elhep/SpaceVPX_FMC_Carrier_3U/IMG/render3U.png

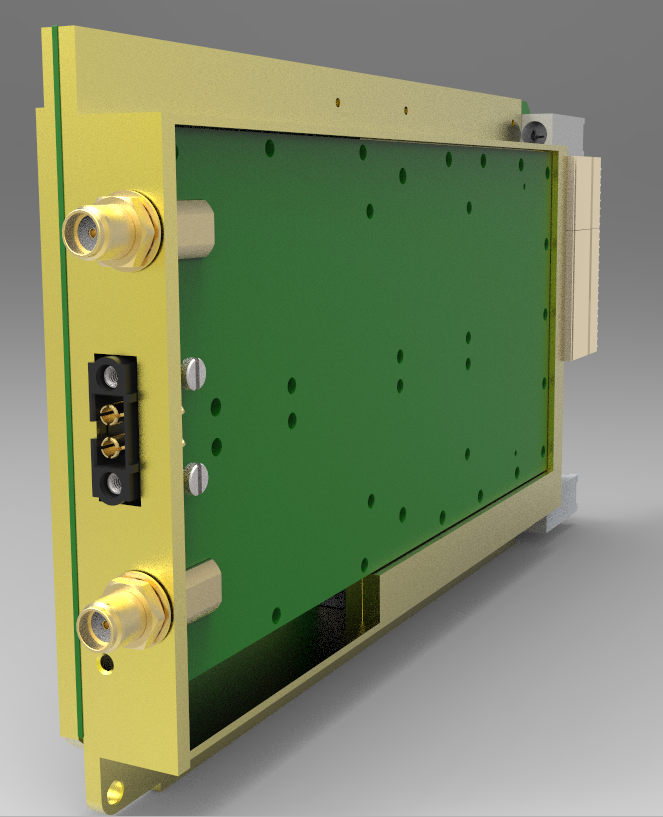
IMG/render3U.png
