elhep/SpaceVPX_FMC_Carrier_3U/IMG/3U_top_with_FMC_SDR.png

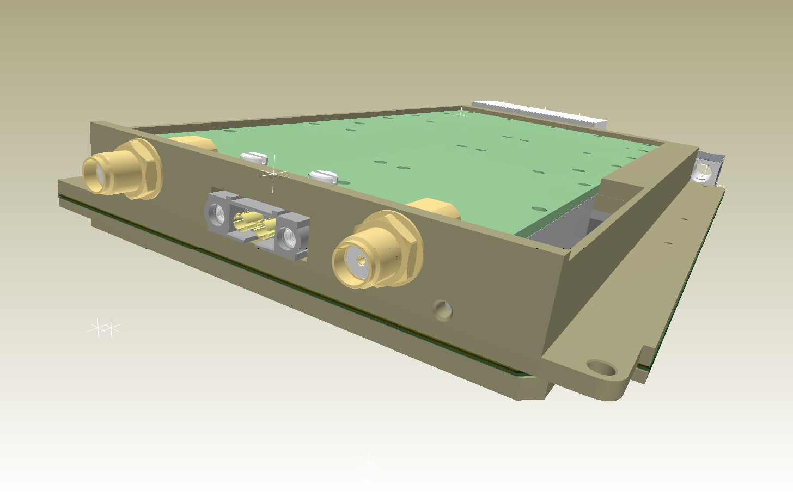
IMG/3U_top_with_FMC_SDR.png
