elhep/SpaceVPX_FMC_Carrier_3U/IMG/3U_top.png

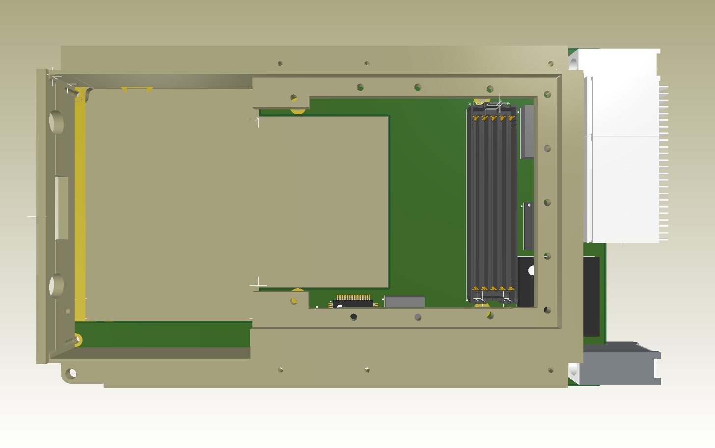
IMG/3U_top.png
