elhep/SpaceVPX_FMC_Carrier_3U/CALC/PSU_Calc.xlsx

LT8610
R2 | Vout | Vin | n | Fsw[MHz] | I load max | RT[k] | Fsw max | R1 | Iq | Lopt[uH] | dIl | IL peak | I out max
1000 | 3.3 | 12 | 0.8 | 1 | 2.5 | 41.3 | 5822784.81 | 2402.061856 | 0.0003351375 | 3.45 | 0.6934782609 | 2.84673913 | 2.65326087
R2 | Vout | Vin | n | Fsw[MHz] | I load max | RT[k] | Fsw max | R1 | Iq | Lopt[uH] | dIl | IL peak | I out max
1000 | 2.5 | 12 | 0.8 | 1 | 2.5 | 41.3 | 4472573.84 | 1577.319588 | 0.0002543041667 | 2.65 | 0.7468553459 | 2.873427673 | 2.626572327
R2 | Vout | Vin | n | Fsw[MHz] | I load max | RT[k] | Fsw max | R1 | Iq | Lopt[uH] | dIl | IL peak | I out max
1000 | 1.5 | 12 | 0.8 | 1 | 2.5 | 41.3 | 2784810.127 | 546.3917526 | 0.0001532625 | 1.65 | 0.7954545455 | 2.897727273 | 2.602272727
LT8612
R2 | Vout | Vin | n | Fsw[MHz] | I load max | RT[k] | Fsw max | R1 | Iq | Lopt[uH] | dIl | IL peak | I out max
1000 | 1 | 12 | 0.8 | 1 | 6 | 41.3 | 1952461.8 | 30.92783505 | 0.0001027416667 | 0.826 | 1.10976594 | 6.55488297 | 8.44511703
