elhep/SpaceVPX_FMC_Carrier_3U/(list of files, drawings)

Other design files:
SVPX.SchLib
SVPX_FMC_3U_PCB/SCH/CLK_Protection.SchDoc
SVPX_FMC_3U_PCB/SCH/Decoupling_caps.SchDoc
SVPX_FMC_3U_PCB/SCH/FMC_connector.SchDoc
SVPX_FMC_3U_PCB/SCH/FPGA SDRAM bank.SchDoc
SVPX_FMC_3U_PCB/SCH/FPGA Supply.SchDoc
SVPX_FMC_3U_PCB/SCH/FPGA_Config.SchDoc
SVPX_FMC_3U_PCB/SCH/FPGA_FMC.SchDoc
SVPX_FMC_3U_PCB/SCH/FPGA_MGT.SchDoc
SVPX_FMC_3U_PCB/SCH/FPGA_Misc.SchDoc
SVPX_FMC_3U_PCB/SCH/FPGA_SpW_Misc.SchDoc
SVPX_FMC_3U_PCB/SCH/Interface_Protection.SchDoc
SVPX_FMC_3U_PCB/SCH/Management.SchDoc
SVPX_FMC_3U_PCB/SCH/MSP430_power_jtag.SchDoc
SVPX_FMC_3U_PCB/SCH/Power_supply.SchDoc
SVPX_FMC_3U_PCB/SCH/SLT3-PAY-1Q2T_P0.SchDoc
SVPX_FMC_3U_PCB/SCH/SLT3-PAY-1Q2T_P1.SchDoc
SVPX_FMC_3U_PCB/SCH/SLT3-PAY-1Q2T_P2.SchDoc
SVPX_FMC_3U_PCB/SCH/SVPX_protection.SchDoc
SVPX_FMC_3U_PCB/SCH/SVPXFMC_Carrier_3U.SchDoc
SVPX_FMC_3U_PCB/SCH/WR_OSC.SchDoc
SVPX_FMC_3U_PCB/SVPXFMC_Carrier_3U.PrjPcb
