elhep/SpaceVPX_FMC_Carrier_3U/(threads)

Thread 1 (2018-10-31):

schematic review

gkasprow, 2018-10-31:

mkuklewski, 2019-02-06:
One of small issue is lack of harnesses files.
Please add them to repository.

gkasprow, 2019-02-06:
Harness files are generated during compilation.

Thread 2 (2019-02-05):

SpaceVPX connector pinout change.

mkuklewski, 2019-02-05:
During further development of the project and review,  the need to change the pinout became apparent.
First all connectors should be grouped to different sheets and named after each connector (and those placed into one, from which all harness should spread) and all pins should be named after standard.

Naming of each sheet should be like this:
SLT3-PAY-1Q2T-HS_COMM
SLT3-PAY-1Q2T-HS_COMM_P0
SLT3-PAY-1Q2T-HS_COMM_P1
etc.

Pinout of the SpaceVPX connector is here:
https://docs.google.com/spreadsheets/d/13T0c5s93cGWtUubSEh7cbfTNiu5ucbjdAXt16fslpvk/edit?usp=sharing

tprzywoz, 2019-03-05:
Done. In MSP430_power_jtag sheet I added TVS diode to MCU_UART.

Closed 2019-06-17.

Thread 4 (2019-02-05):

Fault isolation betwean 12V and 3V3 domains.

biedam, 2019-02-05:
FPGA power supply is not fault isolated from P3V3MP supply. In the case of management failure and 3V3MP cutt-off, whole module is not operable. PG, ENA and MAX4372 power supply should be connected to 12V.

tprzywoz, 2019-03-05:
done

Closed 2019-06-17.

Thread 5 (2019-02-07):

LPDDR

mkuklewski, 2019-02-07:
There are two issues here:
1.  Resistor connected to D7 MDDR_IMP_CALIB (FPGA_Config_SchDoc) should be 150 Ohm (according to Pin_Descripions_Datasheet),
2. Two pins on MT46H64M32LFBQ-48 should be swapped - F2 with E2.

tprzywoz, 2019-03-05:
done

tprzywoz, 2019-04-02:
I'm confused. According to [DS0115](https://www.microsemi.com/document-portal/doc_view/130718-ds0115-smartfusion2-pin-descriptions-datasheet) D7 MDDR_IMP_CALIB resistor should be 150 Ohm and clk lines don't have termination resistor. According to [AC393](https://www.microsemi.com/document-portal/doc_view/129979-ac393-board-and-layout-design-guidelines-for-smartfusion2-soc-and-igloo2-fpgas-application-note) it should be 240 Ohm and there is a 100 Ohm termination at the end of clk lines. M2S090TS-EVAL-KIT is designed according to AC393, although it has same memory chip as DS0115 example.

mkuklewski, 2019-04-02:
In my opinion there is something not mentioned inside AC393 and its configuration (for example IO calibration is off) or there is an error in documentation. I would use 150 Ohms resistor (same voltage as DDR2 interface, which is also not done correctly in this document).
As for 100 Ohm resistor, it should be included, because MT46H64M32LFBQ CLK inputs are differential.

tprzywoz, 2019-04-14:
I used 150 Ohm resistor + added 100 Ohm resistor at LPDDR's CLK inputs

Closed 2019-04-14.

Thread 6 (2019-02-11):

FPGA Supply - Capacitors and resistors

mkuklewski, 2019-02-11:
According to Microsemi_SmartFusion2_IGLOO2_Board_and_Layout_Design_Guidelines_Application_Note_AC393_V13.pdf there is not enough decoupling capacitors.
For XXXX should be:
- VDDI1 - 7 x 0.01 μF,  7 x 0.1 μF, 2 x 47 μF
- VDDI2 - 2 x 0.01 μF,  2 x 0.1 μF, 1 x 10 μF
- VDDI3 - 2 x 0.01 μF,  2 x 0.1 μF, 1 x 10 μF
- VDDI4 - 1 x 0.01 μF, 1 x 10 μF
- VDDI5 - please add to those which already are 2 x 0.01 μF,  2 x 0.1 μF
- VDDI6 - please add to those which already are 2 x 0.01 μF,  2 x 0.1 μF
- VDDI7 - please add to those which already are 2 x 0.01 μF,  2 x 0.1 μF
- VDDI8 - please add to those which already are 2 x 0.01 μF,  2 x 0.1 μF
- VDD - 10 x 0.01 μF, 10 x 0.1 μF, 1 x 100 μF, 3 x 220 μF, 1 x 330 μF
- VPP - 2 x 0.01 μF,  1 x 0.1 μF, 1 x 10 μF
- VREF - we are using it  - each resistor should be 1k Ohm. Capacitors which should be here: 2 x 0.01 μF,  1 x 0.1 μF, 1 x 10 μF
- VPPNVM - not enough capacitors - 1 x 0.01 μF,  1 x 10 μF
- SERDES_0_L01_VDDAIO - is connected to SERDES_0_VDD - Voltage is ok, but there is not enough capacitors
-- SERDES_0_VDD - should be 1 x 0.01 μF,  1 x 0.1 μF, 1 x 10 μF
-- SERDES_0_L01_VDDAIO - should be 1 x 0.01 μF,  1 x 0.1 μF, 1 x 10 μF
- SERDES_0_L23_VDDAIO - should be one 100nF capacitor less

tprzywoz, 2019-03-05:
I added the missing capacitors and replaced resistors. I didn't reduce quantity of capacitors if the capacity was greater than required.

Closed 2019-04-14.

Thread 7 (2019-02-11):

FPGA Config

mkuklewski, 2019-02-11:
FLASH_GOLDEN_N and DEVRST_N are pulled up by 1kOhm - should be 10 kOhm resistor.
JTAG voltage is connected to 2V5 - should be 3V3 - also it would be probably wise to add transil diodes.

tprzywoz, 2019-03-05:
done

tprzywoz, 2019-04-14:
Added new FPGA reset schematics:
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

Closed 2019-04-14.

Thread 8 (2019-05-28):

UART1_TxD wrong pin

mkuklewski, 2019-05-28:
UART1_TxD should be connected to H19 on FPGA_Misc sheet.

tprzywoz, 2019-05-28:
done

Closed 2019-05-28.

Thread 9 (2019-06-07):

JTAG connector

biedam, 2019-06-07:
Use 2mm pitch socket which is already in schematic. If it doesn't fit then try with THT version: (https://katalog.we-online.de/en/em/BHD_2_00_MALE_BOX_HEADER_6250XX21621). It it's still to large, then use vertical Pico-Blade female connector from Molex.

MSP430 JTAG connector is already used in different PCB so it should stay the same as in schematic.

tprzywoz, 2019-06-12:
Used THT version: WR-BHD 2.00 mm Male Box Header 62501021621

Closed 2019-06-12.

Thread 10 (2019-06-17):

PCB review

tprzywoz, 2019-06-17:

mkuklewski, 2019-06-26:
Ok, thank you for your time :)

Here are couple issues - which justification can be found in the ECSS-Q-ST-70-12C(14July2014).pdf:
0. All vias should be exposed, if it is possible - because we are using solder mask (although it shouldn't be used) and all traces are between are hidden between top and bottom layers, it is very hard to access them (like under BGA) and debug if something is not right.
1. If it is possible please change via's annual ring size to 100um,
2. **Please expose top and bottom parts of the PCB which are used as thermal interface for wedge locks (NIC design),**
3. No copper balancing on TOP and BOTTOM layers,
4. **Power planes on layer from L2 to L4 - they should be spilled over whole PCB to ensure homogeneous copper distribution and proper heat distribution (please check NIC design) - but not connected to TOP and BOTTOM layers**
5. Grid should be offset between layers and should be placed symmetrically within the build-up to minimise warp and twist.
6. Tear drop reinforcement of pads to tracks can be used for a more robust design and to mitigate the risk of a smaller designed diameter.

Here are some other issues:
1. Please include test points for: all power rails, reset signal, SpaceWire_A, PROBE_A and _B (W10 and Y10 pins) (I would like to add more, but there is already no space )
2. There are no fiducial markers
3. **Power Good lines (and PWR_OVLn) are connected directly to MCU  - please connected them trough resistor divider - those lines are pulled up to P12V0**
4. Connect CLK_DIR to configurable resistor - at least for now (should be configured that carrier is master)
5. I think for GBT we need to choose default configuration - probably it will be better to connect them to UltraThin Pipes Data
6. FRAM PWR A can be deleted

I guess that's all for now

gkasprow, 2019-06-26:
Please make a dedicated issue and copy [this](https://github.com/sinara-hw/sinara/wiki/PCBReviewChecklist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) and https://github.com/sinara-hw/sinara/wiki/PCBReviewChecklist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 checklists. Mark every item once it is verified

gkasprow, 2019-06-26:
I updated the links to the checklists.

gkasprow, 2019-06-26:
a few remarks

> Power planes on layer from L2 to L4 - they should be spilled over whole PCB to ensure homogeneous copper distribution and proper heat distribution (please check NIC design) - but not connected to TOP and BOTTOM layers

this is not a good idea. it's much better to use copper balancing. Solid, not connected polygon acts as an antenna and causes unwanted couplings.

>
> All vias should be exposed, if it is possible - because we are using solder mask (although it shouldn't be used) and all traces are hidden between top and bottom layers, it is very hard to access them (like under BGA) and debug if something is not right.

Only certain vias should be exposed. Vias must be exposed either on both sides or not at all.
It's better to use 1mm test pads. Vias as test points are poor because can be damaged with a single touch of the probe. Exposed vias under BGA are asking for troubles.
So expose only vias which must be esposed, i.e. under the thermal pads.

we are using solder mask, so why not to use copper balancing on top and bottom?

mkuklewski, 2019-06-27:
>
>
> Please make a dedicated issue and copy [this](https://github.com/sinara-hw/sinara/wiki/SchematicsReviewChecklist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) and [this](https://github.com/sinara-hw/sinara/wiki/PCBReviewChecklist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) checklists. Mark every item once it is verified

I have started doing it according to the PCB checklist and I am a halfway through.

> >Power planes on layer from L2 to L4 - they should be spilled over whole PCB to ensure homogeneous copper distribution and proper heat distribution (please check NIC design) - but not connected to TOP and BOTTOM layers

>this is not a good idea. it's much better to use copper balancing. Solid, not connected polygon acts as an antenna and causes unwanted couplings.

I did not meant big solid, not connected polygons, but ground and power planes (in form of grid) which are already there - but increase their size to match PCB size. If they wont be placed then our thermal interface will be very poor.
This is how SpaceVPX_FMC_Carrier looks right now (without TOB and BOTTOM layers):
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

And this is how NIC design looks:
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

> Only certain vias should be exposed. Vias must be exposed either on both sides or not at all.
> It's better to use 1mm test pads. Vias as test points are poor because can be damaged with a single touch of the probe. Exposed vias under BGA are asking for troubles.
> So expose only vias which must be esposed, i.e. under the thermal pads.

Ok, then please increase number of test points. Although we really should start thinking about prototyping PCBs without solder mask...

> we are using solder mask, so why not to use copper balancing on top and bottom?

I have pointed it out as one of the issues - that there is no copper balancing on top and bottom.

mkuklewski, 2019-06-27:
Also I am wondering if this distance between plane and differential line is ok?
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

gkasprow, 2019-06-27:
no, that's not correct. Such low distance will affect trace impedance. Please increase clearance at least to 15mils.

tprzywoz, 2019-07-04:
> 1. Please include test points for all power rails, reset signal, SpaceWire_A, PROBE_A and _B (W10 and Y10 pins) (I would like to add more, but there is already no space )

Do you need test points for both differential lines of SpaceWire? There isn't much space and it would be easier with 4 TP.

gkasprow, 2019-07-04:
For SpW we have already SVPX connectors pads.

tprzywoz, 2019-07-04:
> 4. Connect CLK_DIR to configurable resistor - at least for now (should be configured that carrier is master)

What is the configuration of a master carrier? In standard FMC that pin is floating.

> 5. I think for GBT we need to choose default configuration - probably it will be better to connect them to UltraThin Pipes Data

Is this the final decision? I added UltraThin Pipes Data as an alternative connection - "old default" was FMC connection.

gkasprow, 2019-07-04:
Do you mean CLK DIR in FMC? It is sensed by carrier. We don't really care because our board is LPC so the CLK DIR has no function.
For GBT we need to setup connection between FPGA and Jetson PCIe. UTP has only single lane.
FMC is one option, UTP is another.

mkuklewski, 2019-07-05:
> Do you mean CLK DIR in FMC? It is sensed by carrier. We don't really care because our board is LPC so the CLK DIR has no function.

Ok, I thought that CLK DIR was set by the carrier to inform the FMC about the direction of the clock.

> For GBT we need to setup connection between FPGA and Jetson PCIe. UTP has only single lane.
> FMC is one option, UTP is another.

I guess our first usage will be most likely connecting FPGA to Jetson PCIe, rather than to FMC :)
Anyway - if it is configurable, we can always change it.

tprzywoz, 2019-07-09:
> 1. All vias should be exposed, if it is possible - because we are using solder mask (although it shouldn't be used) and all traces are hidden between top and bottom layers, it is very hard to access them (like under BGA) and debug if something is not right.

>Only certain vias should be exposed. Vias must be exposed either on both sides or not at all.

Only vias in thermal pads (power IC) are exposed.

> 2. If it is possible please change via's annual ring size to 100um,

All vias annual ring changed to 100 um.

> 3. **Please expose top and bottom parts of the PCB which are used as thermal interface for wedge locks (NIC design),**

done
> 4. No copper balancing on TOP and BOTTOM layers,

done
> 5. **Power planes on layer from L2 to L4 - they should be spilled over whole PCB to ensure homogeneous copper distribution and proper heat distribution (please check NIC design) - but not connected to TOP and BOTTOM layers**

done
> 6. Grid should be offset between layers and should be placed symmetrically within the build-up to minimise warp and twist.

done
> 7. Tear drop reinforcement of pads to tracks can be used for a more robust design and to mitigate the risk of a smaller designed diameter.

done

> 1. Please include test points for: all power rails, reset signal, SpaceWire_A, PROBE_A and _B (W10 and Y10 pins) (I would like to add more, but there is already no space )

All added except SpaceWire_A

> 2. There are no fiducial markers

Added
> 3. **Power Good lines (and PWR_OVLn) are connected directly to MCU  - please connected them trough resistor divider - those lines are pulled up to P12V0**

Added 3,6 kOhms to GND for 10 k pullup and 24 kOhms to GND for 68 k pullup. I changed also net label - rail P1V8 has P1V5 Power Good net label.
> 4. Connect CLK_DIR to configurable resistor - at least for now (should be configured that carrier is master)

Without changes

> 5. I think for GBT we need to choose default configuration - probably it will be better to connect them to UltraThin Pipes Data

Created default variant with connection to UltraThin Pipes Data

> 6. FRAM PWR A can be deleted

Deleted

tprzywoz, 2019-07-10:
> Also I am wondering if this distance between plane and differential line is ok?

Plane to differential line distance increased to 0.4 mm.
I left only distance between plane and via's of differential line to prevent power plane from cutting under the FPGA and FMC.

mkuklewski, 2019-07-16:
1.	There is no keep-out lines on the central part of the PCB. I think we should include them. This will limit size of installed FMC’s shield.
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

2.	The distance from the via must be increased – via itself cannot be moved due to the FMC standard. This means that we will need to reduce the size of the board’s shield that will be installed here (because of DRC and keep-out).

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

3.	TVS diodes should be placed much closer to the SpaceVPX connector – not under protected IC (all of them) – impedance issue
4.	Inside PCB Checklist components and test pads should be placed min. 200 mils from the EDGE – but there is no place for this. Probably the best would be to create 10-20mils keep-out lines and check if it is ok. The same goes for the traces (those should be min. 20mils).
5.	Top overlay should be read only in one or two directions,
6.	PCIE signals are too close to each other on Layer 3:

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

7.	Same problem with signals on L1

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

8.	PCIE links go over different power planes – I guess there is not enough space to route it differently?

Ok, couple simple issues:
10.	Tear drop reinforcement are placed only at one side of the line- I am not sure how to solve this

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

11.	Change the polygon boundaries in such a way that they overlap with the inner layers - this is mainly about TOP and BOTTOM, on the left side of the PCB.

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

12.	One name of the IC’s is placed on solder pads
 
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

Is it possible to enable DRC which will check if soldermaks is placed directly on copper?

13.	Please add No ERC directives to FPF32701MX – PGOOD pin and LM339AD output pin so there will be no error on compilation.

14.	Please sign Probe A and B signal – it can be just “A” and “B”
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

15.	Please delete “a b c …”

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

16.	Could you change those test point to the same type as on the other side of the PCB and sign them? Like “TP1”, “TP2”, etc.
17.	No company logo, copyright notice, date code, pcb number, pcb revision, assembly revision blank on silkscreen, serial number blank on silkscreen
18.	Same fiducial markers are used – not really an issue
19.	No stackup information on Layer 1 or drill leyer
20.	Is there a need to leave those GND vias unmasked on bottom layer?

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

21.	Hole tolerances are not noted anywhere

tprzywoz, 2019-07-24:
> 1. There is no keep-out lines on the central part of the PCB. I think we should include them. This will limit size of installed FMC’s shield.

added

> 2. The distance from the via must be increased – via itself cannot be moved due to the FMC standard. This means that we will need to reduce the size of the board’s shield that will be installed here (because of DRC and keep-out).

Fixed.  Board Cutout was reduced

> 3. TVS diodes should be placed much closer to the SpaceVPX connector – not under protected IC (all of them) – impedance issue

Replaced  D21, D9, D16, D22A, D23A

> 4. Inside PCB Checklist components and test pads should be placed min. 200 mils from the EDGE – but there is no place for this. Probably the best would be to create 10-20mils keep-out lines and check if it is ok. The same goes for the traces (those should be min. 20mils).

With new rules there is min 5 mm (about 20mils) distance from the edge.

> 5. Top overlay should be read only in one or two directions,

Fixed

> 6 & 7 . PCIE signals are too close to each other on Layer 3:

fixed

> 8. PCIE links go over different power planes – I guess there is not enough space to route it differently?

It seems to me that it is impossible to do that without an addidtional layer.

> Ok, couple simple issues:
> 10.	Tear drop reinforcement are placed only at one side of the line- I am not sure how to solve this

I found out that some of tear drops disappear when I put keep-out grid to generate copper balancing polygon. Now with different action order, it should be ok.

> 11. Change the polygon boundaries in such a way that they overlap with the inner layers - this is mainly about TOP and BOTTOM, on the left side of the PCB.

done

> 12. One name of the IC’s is placed on solder pads
> Is it possible to enable DRC which will check if soldermaks is placed directly on copper?

Ic15 switched off. I added DRC rule and fixed all collision errors.

> 13. Please add No ERC directives to FPF32701MX – PGOOD pin and LM339AD output pin so there will be no error on compilation.

done

> 14. Please sign Probe A and B signal – it can be just “A” and “B”

done

> 15. Please delete “a b c …”

done

> 16. Could you change those test point to the same type as on the other side of the PCB and sign them? Like “TP1”, “TP2”, etc.

done

> 17. No company logo, copyright notice, date code, pcb number, pcb revision, assembly revision blank on silkscreen, serial number blank on silkscreen

On silkscreen added board name, version, date. On schematics WUT logo, copyright notice, date, pcb name, pcb revision

> 19. No stackup information on Layer 1 or drill leyer

added

> 5. Is there a need to leave those GND vias unmasked on bottom layer?

@gkasprow:
>Only certain vias should be exposed. Vias must be exposed either on both sides or not at all.

mkuklewski, 2019-08-13:
Ok, thank you very much.
During next review I have found following issues:

After placing normal FMC card with shield it is impossible to mount it, please move those components
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

L2 layer - differential lines are 4 mils apart - which is too close. Can you create a rule check which will check it?
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

Next step will be HyperLynx simulations - power and signal integrity

mkuklewski, 2019-08-16:
Also, after today meeting we have decided to slightly modify grounding scheme.
Please connect "shell" net to mounting hole of SpaceVPX connector - K1 and K2.

tprzywoz, 2019-08-16:
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

Done

>
> L2 layer - differential lines are 4 mils apart - which is too close. Can you create a rule check which will check it?

New rule keeps lines min. 0.3 mm apart (more than 2 x diff gap) - with two exceptions: area under FPGA  and distance to SMD pad (jumpers for optional connection)

>
> Please connect "shell" net to mounting hole of SpaceVPX connector - K1 and K2.

4 "pads" objects changed to "plated" and connected to "shell"

tprzywoz, 2019-09-17:
Last changes:
added transistor switch to SM STAT (R197 R198 T4)
mechanical changes
added via's and modified polygons for 3P3V, VADJ

Thread 12 (2019-06-27):

missing schematic files

gkasprow, 2019-06-27:
@tprzywoz please add missing SVPX connector schematic files to the repo.

Thread 14 (2019-09-10):

SI verification

tprzywoz, 2019-09-10:
Enable lossy simulation ON
Enable surface roughness ON
Loss tangent 0.02

DDR:
416 MT/s
Timing models DDR_400 (correct for lpddr chip, couldn't find information about FPGA)
Included crosstalk effects
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

There is a problem with timing for data write. LPDDR has 480 ns setup and hold time. Margin has failed only because of high output variation (300 ps). Simulated setup and hold time is about ~750 ps. All signals have matched lengths rule with tolerance 0.1 mm.

tprzywoz, 2019-09-10:
UTP:
VPX connector uses fpga ami ibis model. 5 Gbps.
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

tprzywoz, 2019-09-10:
SpW. VPX connector again uses fpga models. 200 MHz
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

Closed 2019-09-19.

Thread 15 (2019-09-10):

PI verification

tprzywoz, 2019-09-10:
P1V2:
CORE: 2A
SERDES: 0.2 A
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
Max voltage drop 22.6 mV
Max current density 43.2A/mm2
Max via current 756.9 mA

tprzywoz, 2019-09-10:
P1V8 (LPDDR)
FPGA: 50 mA
LPDDR: 170 mA
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

Max Voltage Drop 0.658% (11.8mV)
Max Current Density 9.7A/mm2
Max Via Current 106.8mA

Closed 2019-09-19.

Thread 16 (2019-09-19):

Mechanical issues

mkuklewski, 2019-09-19:
1. 8 holes on PCB sides, should be fi 2,2mm (for M2 screws) - right now some of them are smaller
2. The minimum distance from the side edges of Carrier PCBs to the nearest component or pad should be 12.5 mm. - This will ensure proper case placement
3. The minimum distance from the side with SpaceVPX connector to the nearest component or pad should be 14.5mm. Although here it is not required - only nice to have. We have decided to make a 1-2mm cut-out in the case on this side.

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

[SVPX_3U_080_PCB_obrys_bazowy_20190828.PDF](https://github.com/elhep/SpaceVPX_FMC_Carrier_3U/files/3631064/SVPX_3U_080_PCB_obrys_bazowy_20190828.PDF)

tprzywoz, 2019-09-23:
1. fixed
2. done with exception: J1 J3. There is no way to fit them.
3. I left this one.  It would require a lot of work with replacement, so if it's not necessary...

Closed 2020-01-07.

Thread 17 (2019-09-30):

cosmetics

gkasprow, 2019-09-30:
@tprzywoz
- do not place fabrication files in the repo. Use releases, as we do in other SInara projects. All pdf, gerbers etc go there. The release is bonded to the commit number.
- missing description of critical components: trimpots (add short info like "5V current"), some test points, programmer connectors. Describe their function, not only designator
- avoid placing solid copper below pins like here
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
This will confuse the AOI test. Don't have to fix them right now.
-In next release place thermal conducting copper strip not only on top and bottom, but also on 2 inner layers to lower the thermal resistance.
After fixing silkscreen info, send link to the production files directly to the manufacturer.

tprzywoz, 2019-10-03:
Added description: 4x trimpots, MMC and FPGA JTAG connectors, 2x test points.
Fabrication files go to release assets (no update in commit).

Thread 18 (2020-01-03):

1V2 voltage rail

mkuklewski, 2020-01-03:
Hello,
after powering up the device, we found out that R2 resistor is to small - it should be 9k1 which is used as R6 - but why are they both there?

I think R2 value is the residue to mount IGLOO2 instead of SmartFusion2, because with this voltage is 1V05. Can you create a proper variant?

gkasprow, 2020-01-03:
R2 should be DNP by default. R6 has the correct value. It makes sure that 1V2 core voltage is 1.2V even with a voltage drop on R20.
If the FPGA core voltage drop is too high, the  R62 can be assembled instead of R6 to compensate for all PDN drop.
R2 can be assembled with 9k1 value only when R20 and IC5 are removed during 1.2V rail debugging.
You don't have to start with Hello posting here :)

mkuklewski, 2020-01-07:
Ok, then @tprzywoz please create a proper mounting variant or update schemes with DNP.
If it is possible then make a note on schemes with description when any of them should be used.

tprzywoz, 2020-01-07:
R2 set to 9k1 and not fitted in default variant.

Thread 19 (2020-01-03):

Problem with power isolation

mkuklewski, 2020-01-03:
Hi,
during test I have found out that when 3V3_AUX is switched off and 12V is on, LM8610 responsible for 1V2 turns off, because PWR_OVLn line drops below 0,86V.
The issue probably is with MSP430 which drains current from PWR_OVLn line (when it is turned off), but I am not 100% percent sure, as further tests must be done.

gkasprow, 2020-01-03:
Each CMOS circuit contains protection diodes. So if you disable 3V3_AUX, it will pull all pins to GND via an embedded diode. So, this is normal behavior.

mkuklewski, 2020-01-07:
It is a normal behaviour, but it cannot stay like that in our system - a series resistors (or different solutions) are required to allow device operate without 3V3_AUX.
Lines with this issue:
- FMC_P12V0_OVCn
- PG_P1V2
- PG_P1V8
- PG_P2V5
- PG_P3V3
- PWR_OVLn

tprzywoz, 2020-01-07:
My proposition:
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

FMC_P12V0_OVCn - is connected only to MSP430 input - 3k6 series resistor.

PG_P1V2 3k6 series resistor. With disable 3V3_AUX, resistor divider gives 1.83 V (we need 1 V for LT8610 enable input)

PG (1.8 V, 2.5 V, 3.3 V) each 39k series resistor. Again divider gives 2.15 V (we need 2.1 V for T3B)

PWR_OVLn: I added MOSFET to allow MSP430 to reset power. PWR_OVL is now active High.

biedam, 2020-01-15:
In the lines PG_P1V8, PG_P2V5 and PG_P3V3 there is also the resistor R107 = 10k which dominates the pull-up. I propose to increase this resistor to 100k.

Also the PWR reset line is unnecessary since the MSP430 can reset the FPGA. Power cycling will be performed by external power supply. This reset line brings additional spigle point failure.

mkuklewski, 2020-01-15:
> In the lines PG_P1V8, PG_P2V5 and PG_P3V3 there is also the resistor R107 = 10k which dominates the pull-up. I propose to increase this resistor to 100k.

The lines PG_P1V8, PG_P2V5 and PG_P3V3 are indeed pulled up by a 10k resistor, but there is a schottky diode between them. Also PG pins have typical pull-down resistance equals to 680 ohms, which should be enough.

A more significant and necessary change are proposed serial resistors.
I just wonder if MOSFET T6A and T6B and ability to power-cylce by MSP430 are needed.
It seems to me that until we power two cards from one source it doesn't make sense. The 12V latch-up should be detected by the power supply and the rest by using implemented LT8610.

I propose to return to the previous concept and implement a serial resistor, so that MSP430 does not turn off the main power supply (when MSP430 is turned off).

tprzywoz, 2020-01-15:
So I only added resistors 39k serial to each line. Or change them to 68k to keep PG voltage levels higher when MSP430 is turned off?

gkasprow, 2020-01-15:
DOn't use high pullup values. the leakage current may increase with TID.
