elhep/SpaceVPX_FMC_Carrier_3U/(commit log)

2018-10-13 very initial sch and layout
    [CAN_IFC.SchDoc, Channel_supply.SchDoc, DDR4 SDRAM.SchDoc, Decoupling_caps.SchDoc, FMC_Carrier_channel.SchDoc, FMC_connector.SchDoc, FPGA SDRAM bank.SchDoc, FPGA Supply.SchDoc]
2018-10-31 schematics ready for review
    [CAN_IFC.SchDoc, CAN_PHY.SchDoc, Channel_supply.SchDoc, DDR4 SDRAM.SchDoc, Decoupling_caps.SchDoc, FMC_Carrier_channel.SchDoc, FMC_connector.SchDoc, FPGA SDRAM bank.SchDoc]
2019-03-05 fixed issues 2-7
    [Decoupling_caps.SchDoc, FMC_connector.SchDoc, FPGA SDRAM bank.SchDoc, FPGA Supply.SchDoc, FPGA_Config.SchDoc, FPGA_MGT.SchDoc, FPGA_Misc.SchDoc, FPGA_SpW_Misc.SchDoc]
2019-05-06 Added UltraThinPipe
    [FPGA_MGT.SchDoc, SLT3-PAY-1Q2T_P1.SchDoc, SVPXFMC_Carrier_3U.PrjPcb, SVPXFMC_Carrier_3U.SchDoc]
2019-05-20 PCB: LPDDR, FMC, GBT routed
    [CLK_Protection.SchDoc, FMC_connector.SchDoc, FPGA SDRAM bank.SchDoc, FPGA Supply.SchDoc, FPGA_Config.SchDoc, FPGA_FMC.SchDoc, FPGA_MGT.SchDoc, FPGA_Misc.SchDoc]
2019-09-17 Project Outputs + new step file
    [SVPXFMC_Carrier_3U.GBL, SVPXFMC_Carrier_3U.GBO, SVPXFMC_Carrier_3U.GBP, SVPXFMC_Carrier_3U.GBS, SVPXFMC_Carrier_3U.GKO, SVPXFMC_Carrier_3U.GTL, SVPXFMC_Carrier_3U.GTO, SVPXFMC_Carrier_3U.GTP]
2019-09-23 #16 fixed + updated output files and step model
    [SVPXFMC_Carrier_3U.GBL, SVPXFMC_Carrier_3U.GBO, SVPXFMC_Carrier_3U.GBP, SVPXFMC_Carrier_3U.GBS, SVPXFMC_Carrier_3U.GTL, SVPXFMC_Carrier_3U.GTO, SVPXFMC_Carrier_3U.GTP, SVPXFMC_Carrier_3U.GTS]
2019-10-03 #17 fixed
    [SVPXFMC_Carrier_3U.GBL, SVPXFMC_Carrier_3U.GBO, SVPXFMC_Carrier_3U.GBP, SVPXFMC_Carrier_3U.GBS, SVPXFMC_Carrier_3U.GKO, SVPXFMC_Carrier_3U.GTL, SVPXFMC_Carrier_3U.GTO, SVPXFMC_Carrier_3U.GTP]
